LZ1NY/GPSDO_2020/DOCS/GPSDO_2020_FB.jpg

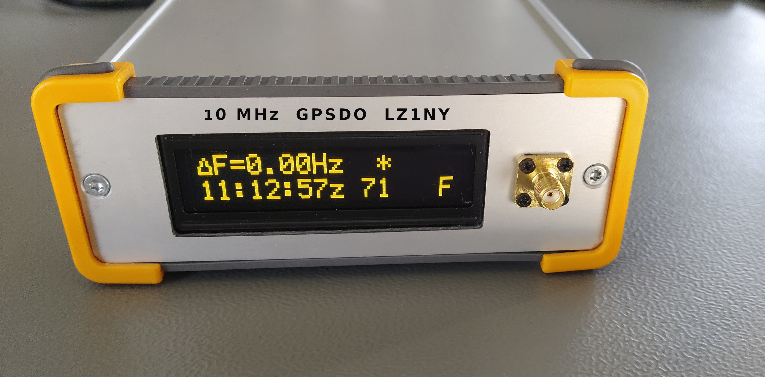
DOCS/GPSDO_2020_FB.jpg
